nhatminhtatran/3-Dof-Robot-Arm/src/Readme.txt

This folder holding Python code for Interface with Robot Arm Arduino by Serial protocol.
