nhatminhtatran/3-Dof-Robot-Arm/SolidWorks/Readme.txt

In this Folder, this is SolidWorks file to design 3-DoF Robot ARM
