nhatminhtatran/3-Dof-Robot-Arm/src/File code/ROBOT_3DOF.png

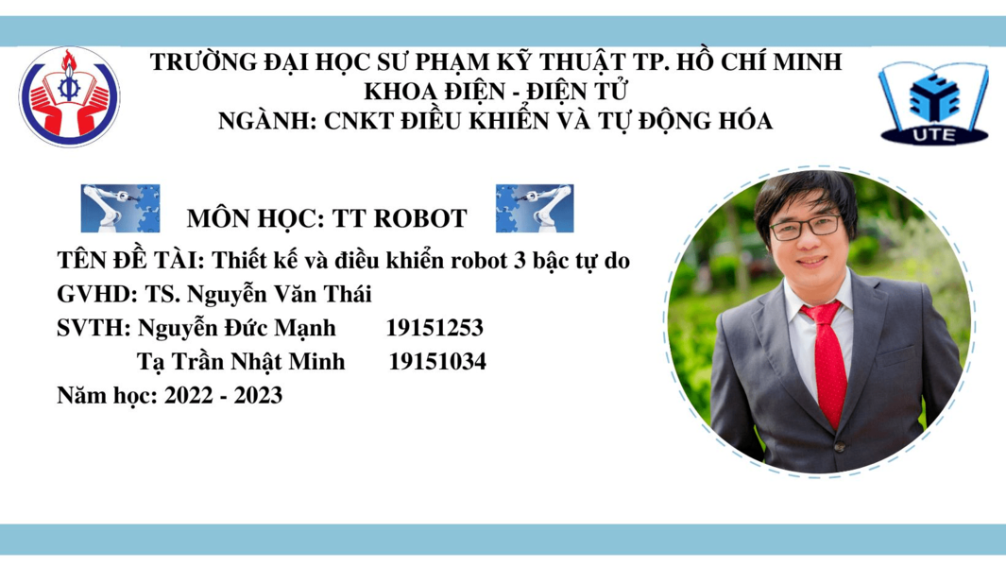
src/File code/ROBOT_3DOF.png
